electrodonkey/roza_reflow_hw/output/reflow_roza.png

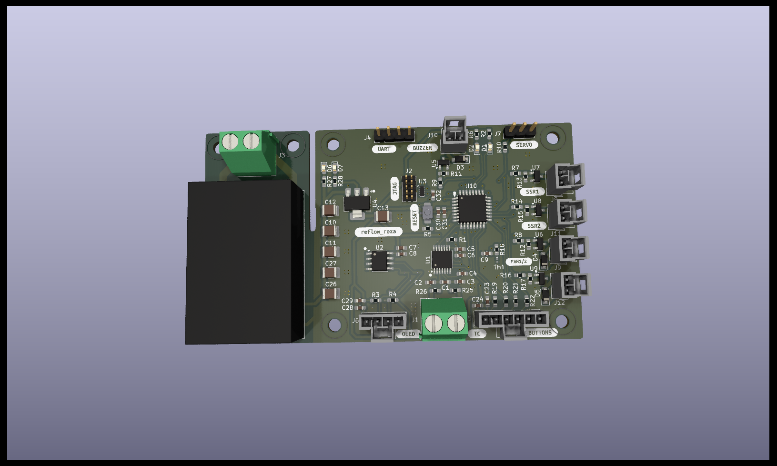
output/reflow_roza.png
