electrodonkey/roza_reflow_hw/3d/molex_nanofit_1053091108.stp

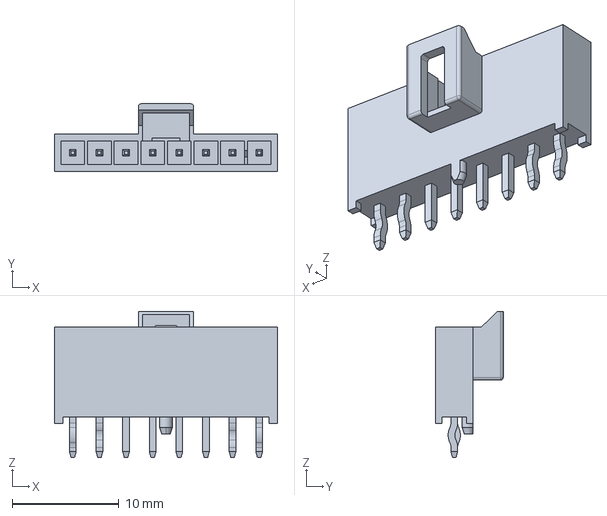
[picture p2: CAD file, 2024-12-30]
3d/molex_nanofit_1053091108.stp
20.9 x 6.34 x 13.7 mm
