electrodonkey/roza_reflow_hw/enclosure/reference/OLED+Display+Case.step

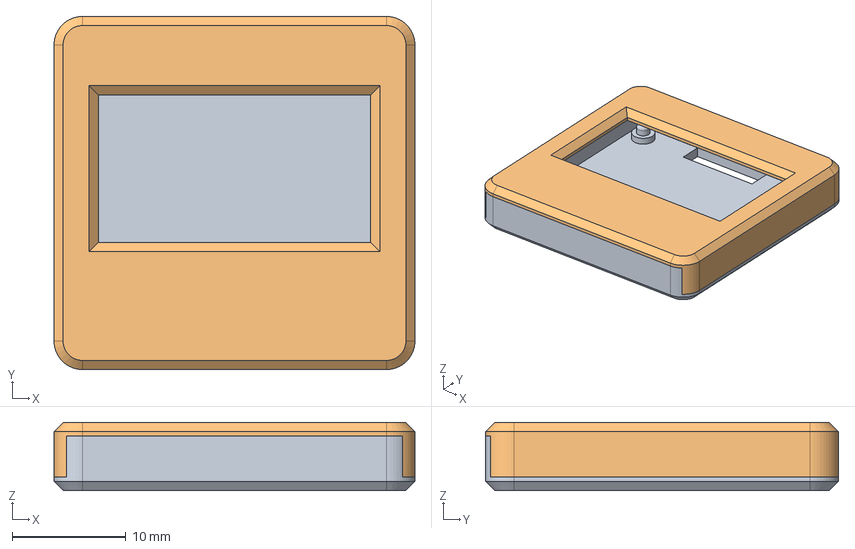
[picture p3: CAD file, 2025-01-08]
enclosure/reference/OLED+Display+Case.step
31.8 x 31.1 x 6.00 mm
Base
Lid
