electrodonkey/roza_reflow_hw/output/reflow_master.step

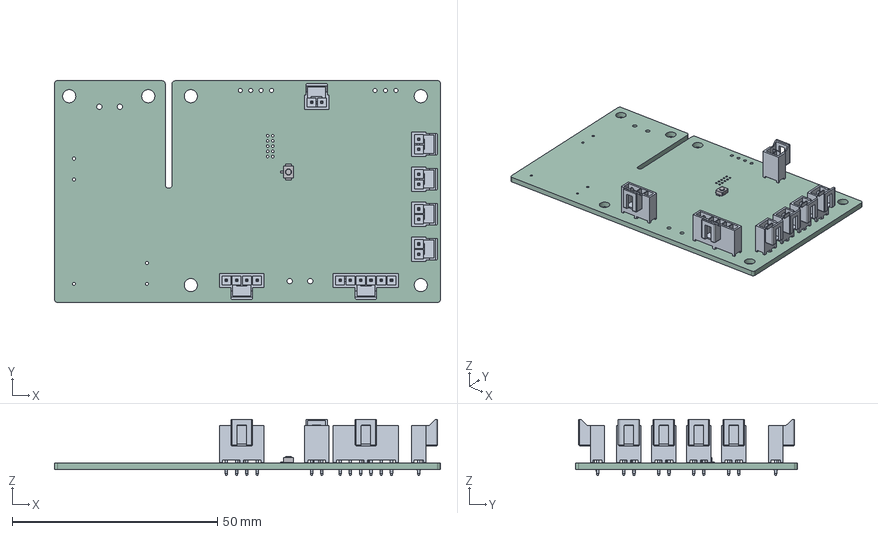
[picture p4: CAD file, 2024-12-30]
output/reflow_master.step
94.0 x 54.0 x 13.7 mm
root
reflow_master_PCB
