electrodonkey/roza_reflow_hw/3d/molex_nanofit_1053091104.stp

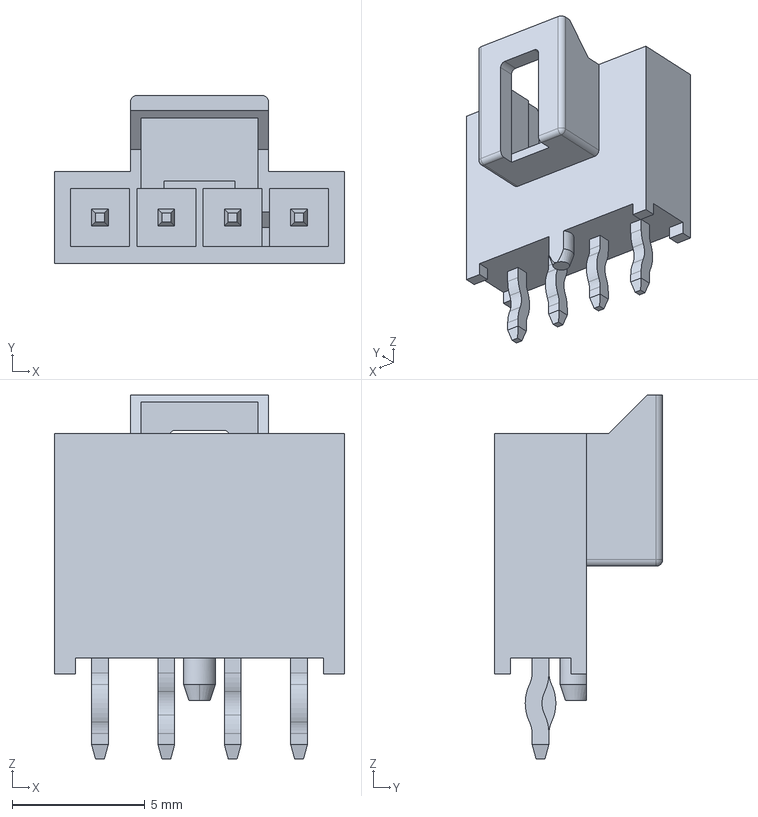
[picture p5: CAD file, 2024-12-30]
3d/molex_nanofit_1053091104.stp
10.9 x 6.34 x 13.7 mm
