electrodonkey/roza_reflow_hw/enclosure/reference/User Library-128x64I2COLEDDisplayAdafruit.step

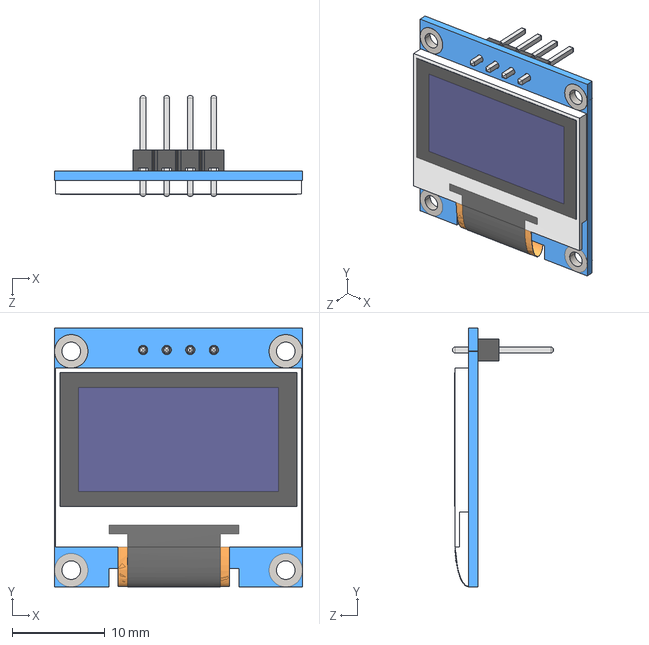
[picture p6: CAD file, 2025-01-08]
enclosure/reference/User Library-128x64I2COLEDDisplayAdafruit.step
26.7 x 27.9 x 10.8 mm
