electrodonkey/roza_reflow_hw/3d/TL1017AABF260QG.stp

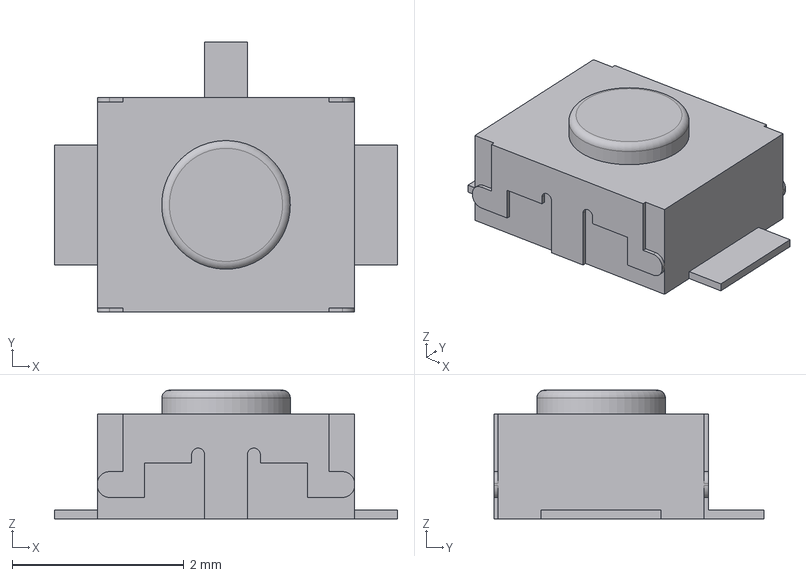
[picture p7: CAD file, 2024-12-30]
3d/TL1017AABF260QG.stp
4.00 x 3.15 x 1.50 mm
