electrodonkey/roza_reflow_hw/3d/molex_nanofit_1053091105.stp

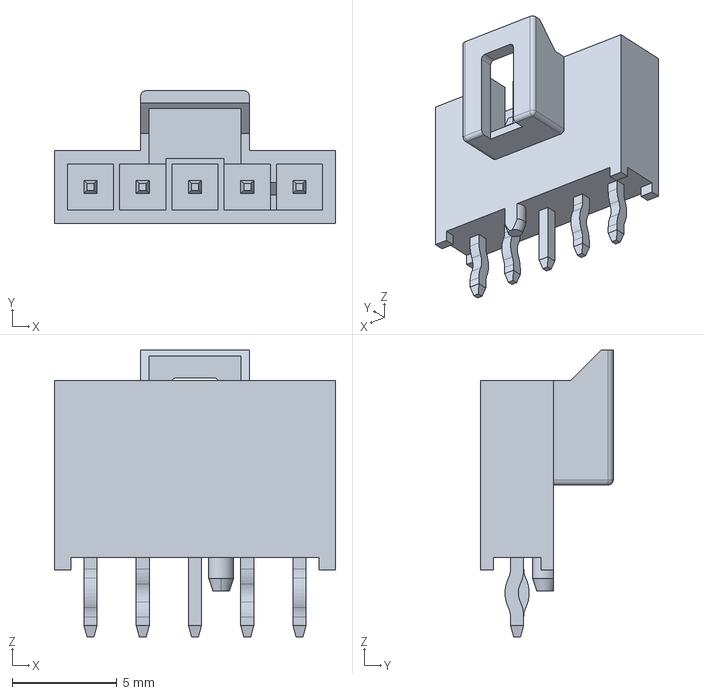
[picture p8: CAD file, 2024-12-30]
3d/molex_nanofit_1053091105.stp
13.4 x 6.34 x 13.7 mm
