electrodonkey/roza_reflow_hw/3d/molex_nanofit_1053091103.stp

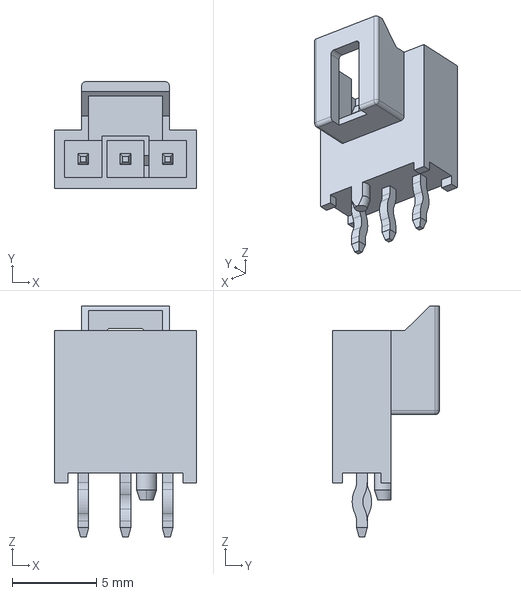
[picture p9: CAD file, 2024-12-30]
3d/molex_nanofit_1053091103.stp
8.44 x 6.34 x 13.7 mm
