electrodonkey/roza_reflow_hw/3d/molex_nanofit_1053091106.stp

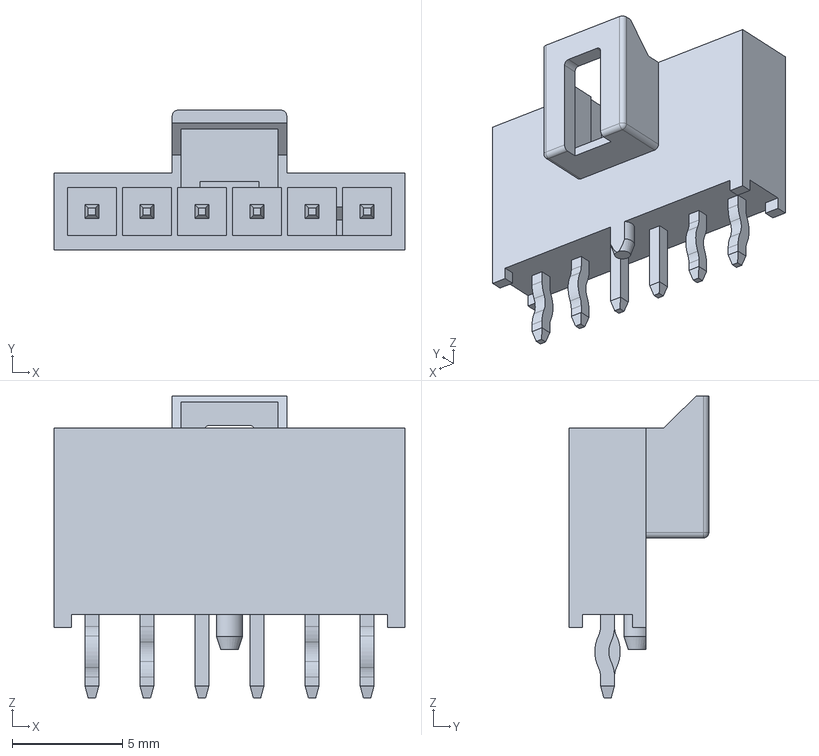
[picture p10: CAD file, 2024-12-30]
3d/molex_nanofit_1053091106.stp
15.9 x 6.34 x 13.7 mm
