electrodonkey/roza_reflow_hw/3d/molex_nanofit_x2_1053091102.stp

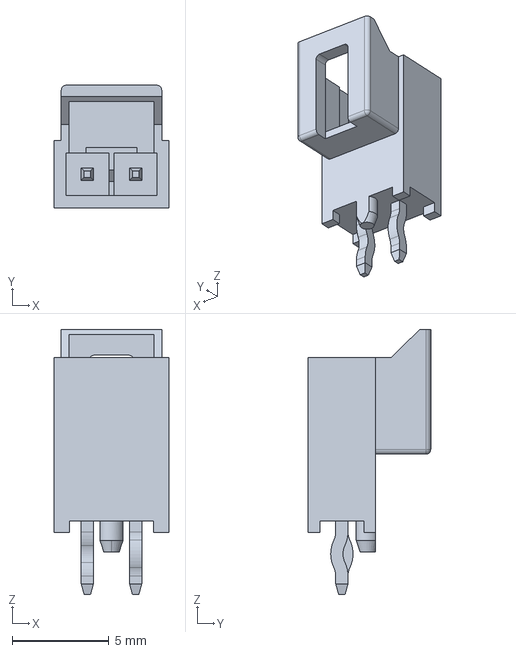
[picture p12: CAD file, 2024-12-30]
3d/molex_nanofit_x2_1053091102.stp
5.94 x 6.34 x 13.7 mm
