electrodonkey/roza_reflow_hw/(list of files, cad)

Other CAD files:
output/enclosure.FCStd
enclosure/reference/OLED+Display+Case.f3d
