electrodonkey/roza_reflow_hw/output/reflow_master.pdf

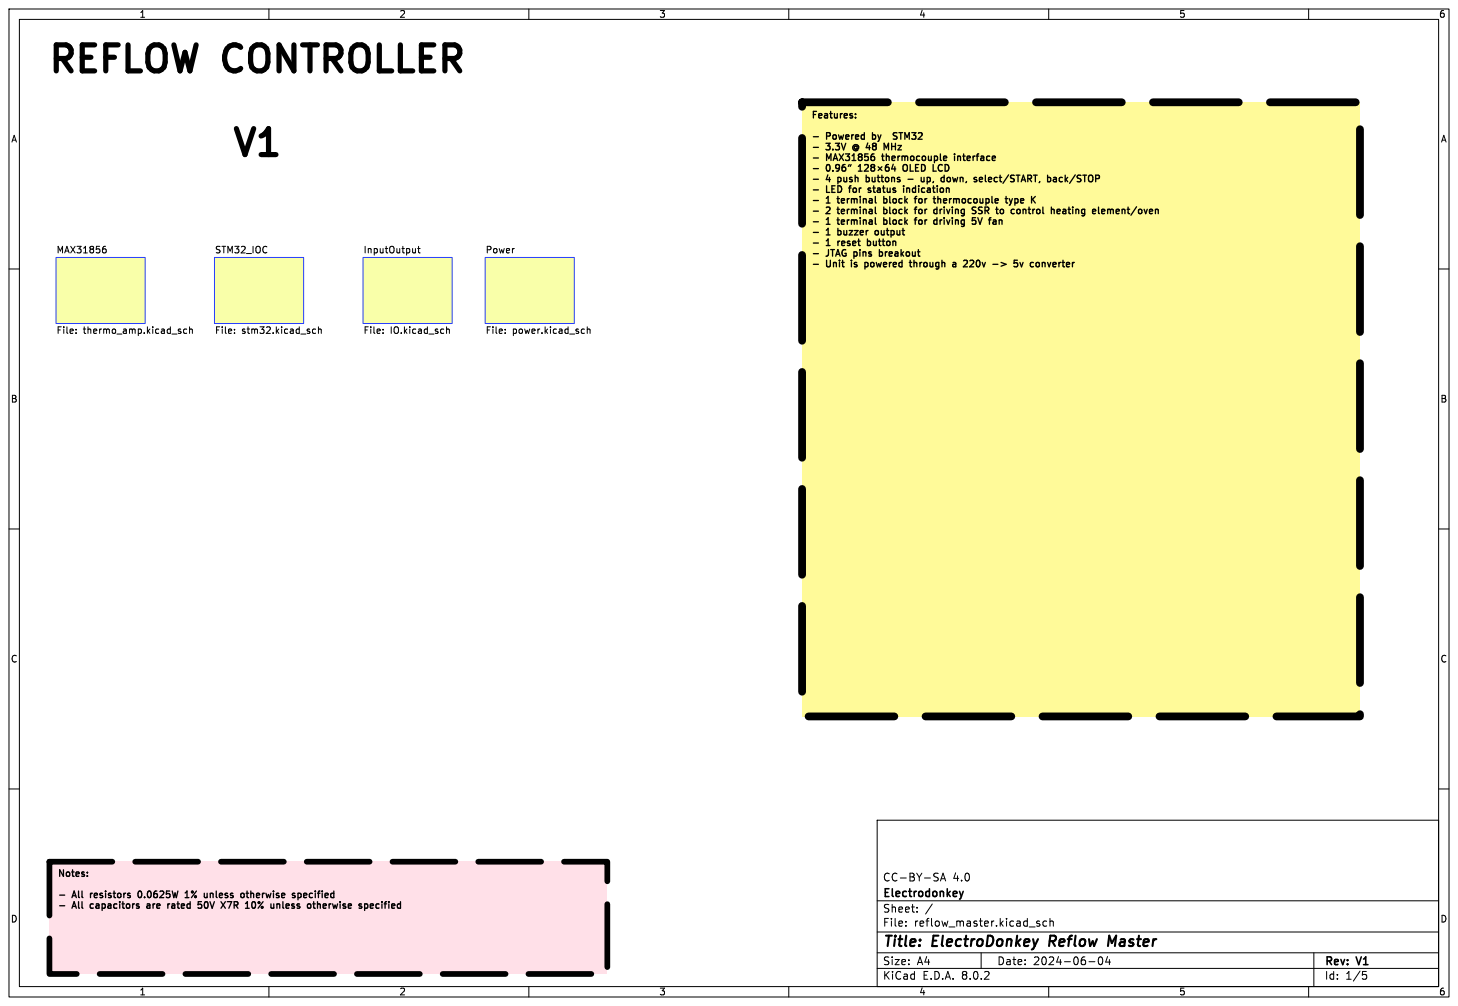
[picture p13: page 1]

- 3.3V @ 48 MHz
- þÿ0.96 3 þÿ128×64OLED LCD
- LED for status indication
- 2 terminal block for driving SSR to control heating element/oven
- 1 terminal block for driving 5V fan
- 1 buzzer output
- 1 reset button
- JTAG pins breakout

- All resistors 0.0625W 1% unless otherwise specified

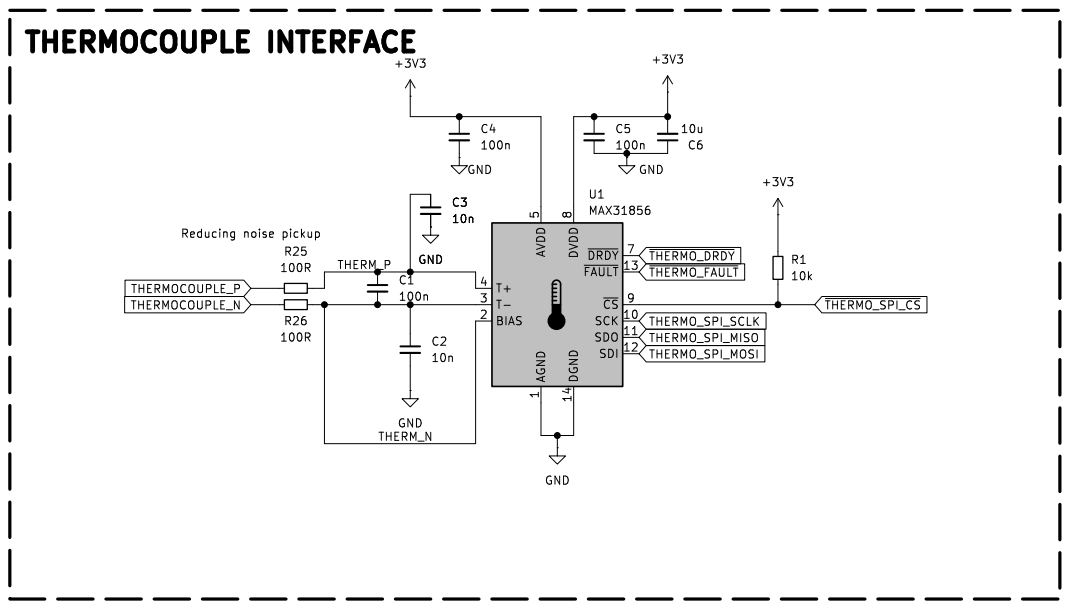
[picture p14: page 2]

1 SCK 10 SDO 11 SDI 12 ~{FAULT} 13 DGND 14 BIAS 2 T- 3 T+ 4 AVDD

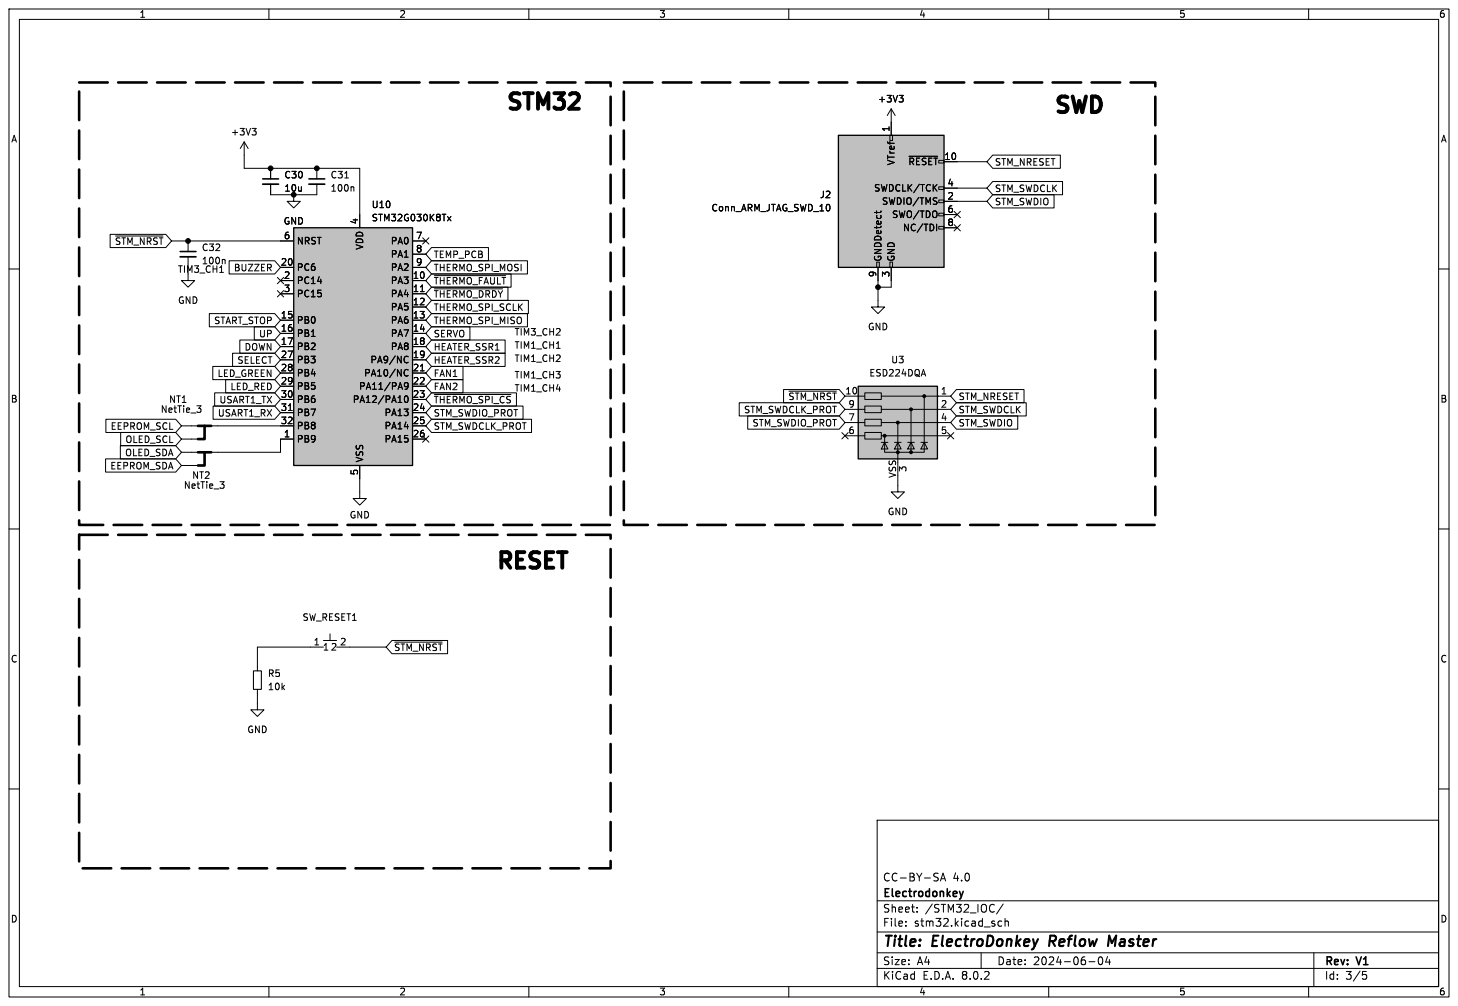
[picture p15: page 3]

3 SWDCLK/TCK 4 SWO/TDO 6 NC/TDI 8 GNDDetect 9 +3V3 GND

5 NRST 6 PA0 7 PA1 8 PA2 9 U10 STM32G030K8Tx +3V3VTref 1 ~{RESET}10 SWDIO/TMS 2 GND

3 SWDCLK/TCK 4 SWO/TDO 6 NC/TDI 8 GNDDetect 9

Id: 3/5 Title: ElectroDonkey Reflow Master File: stm32.kicad_sch Sheet: /STM32_IOC/

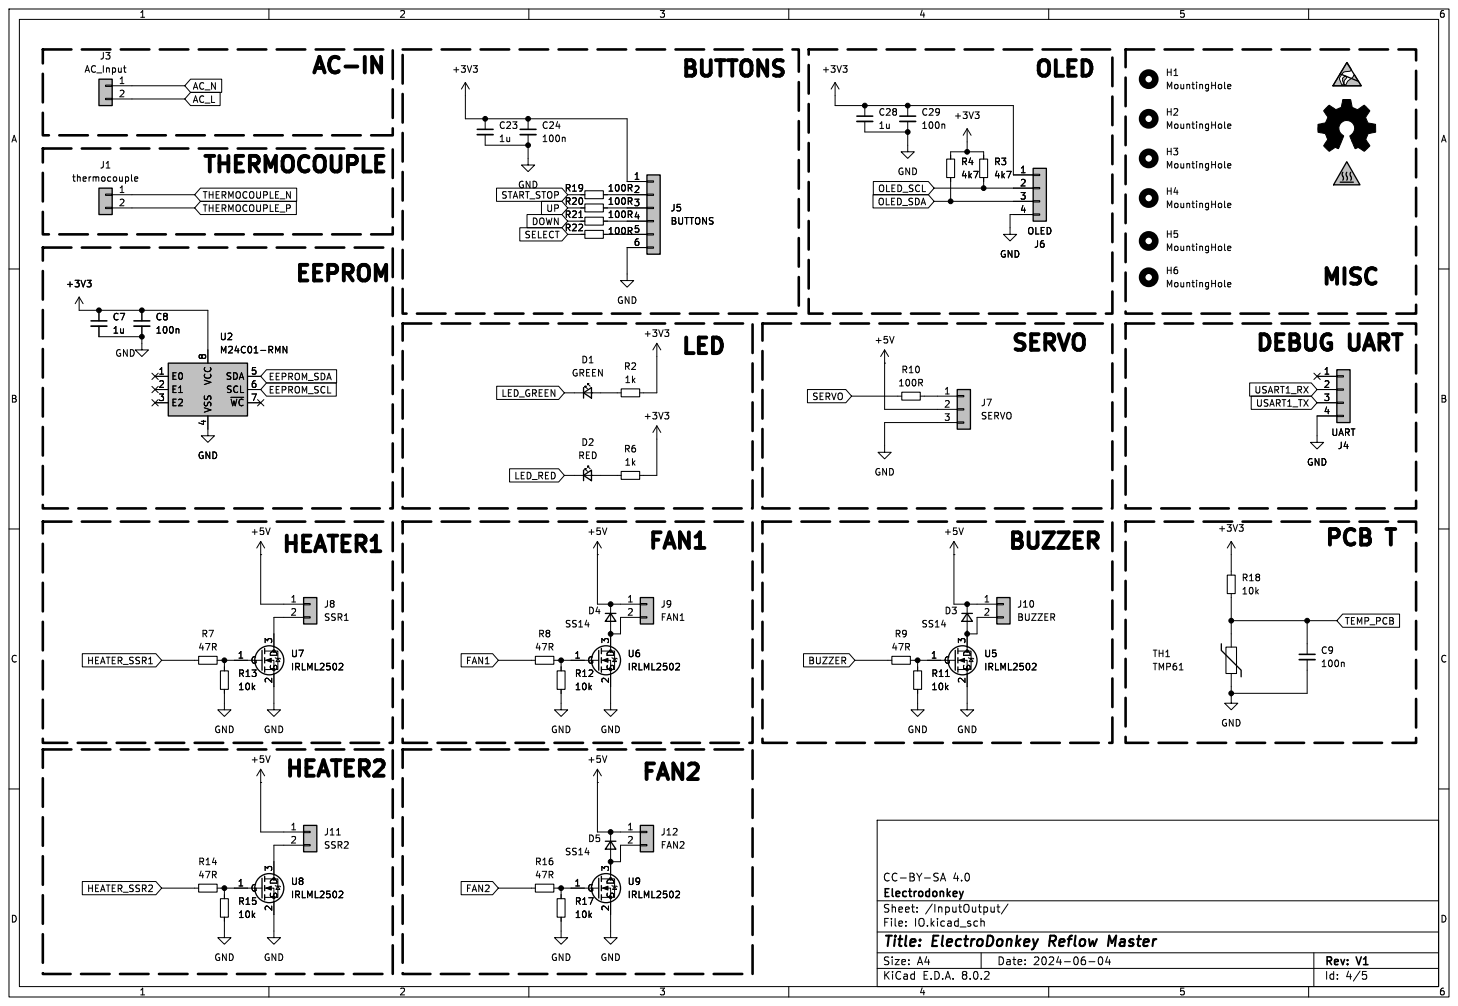
[picture p16: page 4]

4 SDA 5 SCL 6 ~{WC}7 VCC

Id: 4/5 Title: ElectroDonkey Reflow Master File: IO.kicad_sch Sheet: /InputOutput/

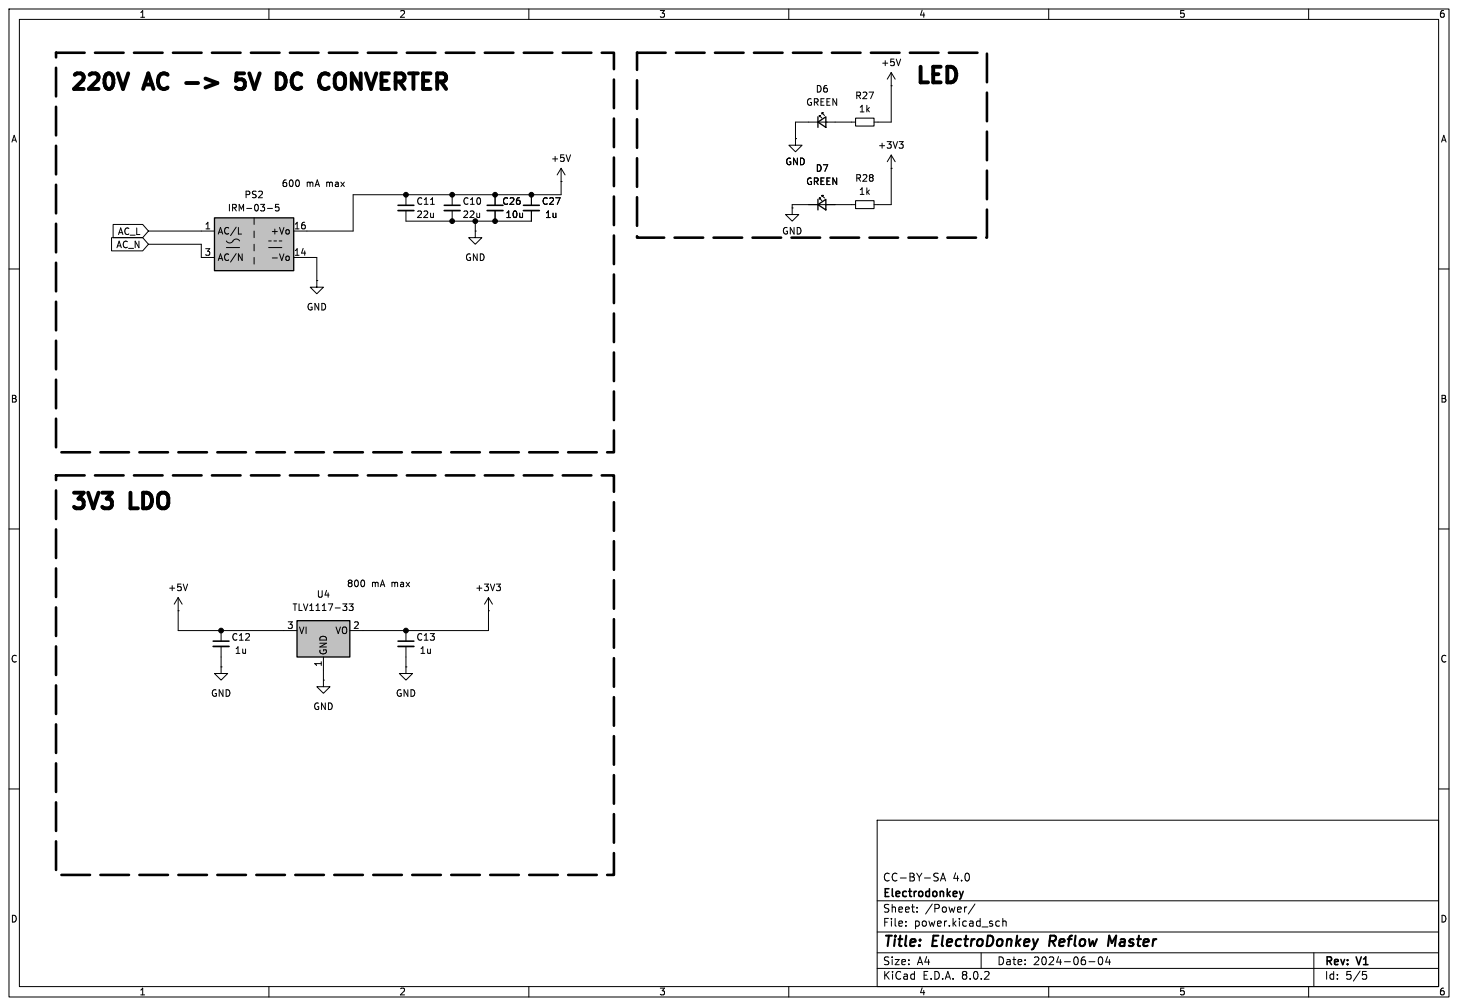
[picture p17: page 5]

1 VO 2 VI 3 U4 TLV1117-33 +3V3 GND GND
