electrodonkey/roza_reflow_hw/reflow_master.kicad_pcb

## KiCad design reflow_master.kicad_pcb (2024-12-30)

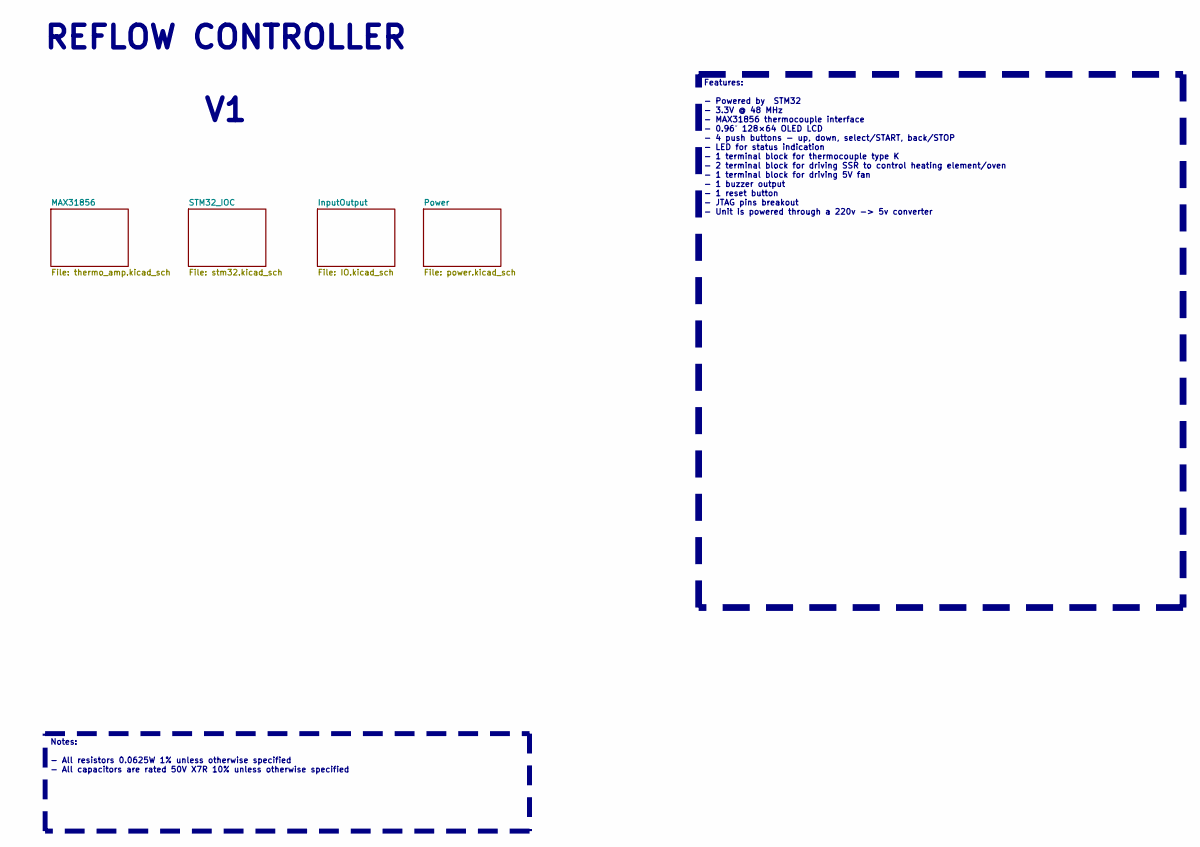
[picture p18: schematic reflow_master.kicad_sch, ElectroDonkey Reflow Master]

Notes on the sheet:
Features: - Powered by STM32 - 3.3V @ 48 MHz - MAX31856 thermocouple interface - 0.96″ 128×64 OLED LCD - 4 push buttons - up, down, select/START, back/STOP - LED for status indication - 1 terminal block for thermocouple type K - 2 terminal block for driving SSR to control heating element/oven - 1 t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
Notes: - All resistors 0.0625W 1% unless otherwise specified - All capacitors are rated 50V X7R 10% unless otherwise specified
REFLOW CONTROLLER ${REVISION}

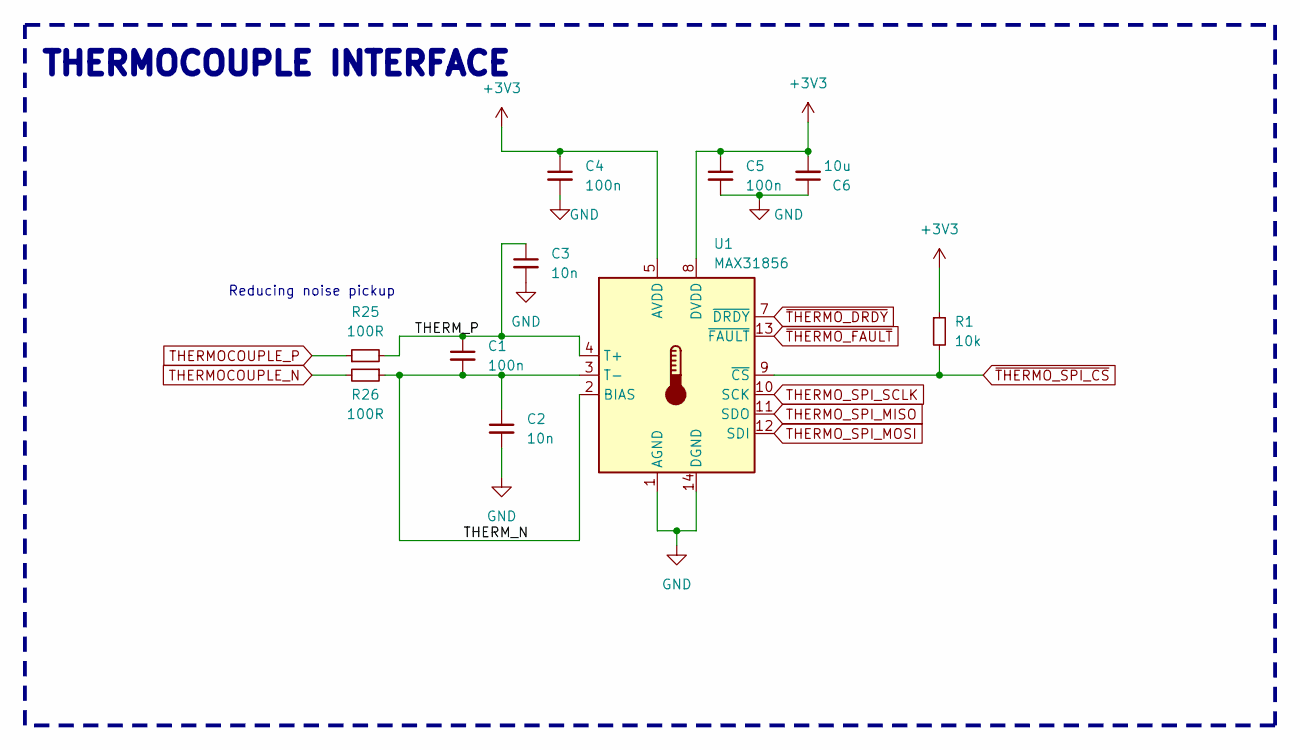
[picture p19: schematic thermo_amp.kicad_sch, ElectroDonkey Reflow Master]

Parts:
C1, C4, C5: 100n; C_0603_1608Metric_Pad1.08x0.95mm_HandSolder
C2, C3: 10n; C_0603_1608Metric_Pad1.08x0.95mm_HandSolder
C6: 10u; C_0603_1608Metric_Pad1.08x0.95mm_HandSolder
R1: 10k; R_0603_1608Metric_Pad0.98x0.95mm_HandSolder
R25, R26: 100R; R_0603_1608Metric_Pad0.98x0.95mm_HandSolder
U1: MAX31856; TSSOP-14_4.4x5mm_P0.65mm

Connections:
+3V3: C4.1, C5.1, C6.2, R1.1, U1.5 (AVDD), U1.8 (DVDD); also elsewhere on the board
/MAX31856/THERM_N: C1.2, C2.1, R26.1, U1.2 (BIAS), U1.3 (T-)
/MAX31856/THERM_P: C1.1, C3.1, R25.2, U1.4 (T+)
GND: C2.2, C3.2, C4.2, C5.2, C6.1, U1.1 (AGND), U1.14 (DGND); also elsewhere on the board
THERMOCOUPLE_N: R26.2; also elsewhere on the board
THERMOCOUPLE_P: R25.1; also elsewhere on the board
THERMO_SPI_MISO: U1.11 (SDO); also elsewhere on the board
THERMO_SPI_MOSI: U1.12 (SDI); also elsewhere on the board
THERMO_SPI_SCLK: U1.10 (SCK); also elsewhere on the board
~THERMO_DRDY: U1.7 (~DRDY); also elsewhere on the board
~THERMO_FAULT: U1.13 (~FAULT); also elsewhere on the board
~THERMO_SPI_CS: R1.2, U1.9 (~CS); also elsewhere on the board

Notes on the sheet:
Reducing noise pickup
THERMOCOUPLE INTERFACE

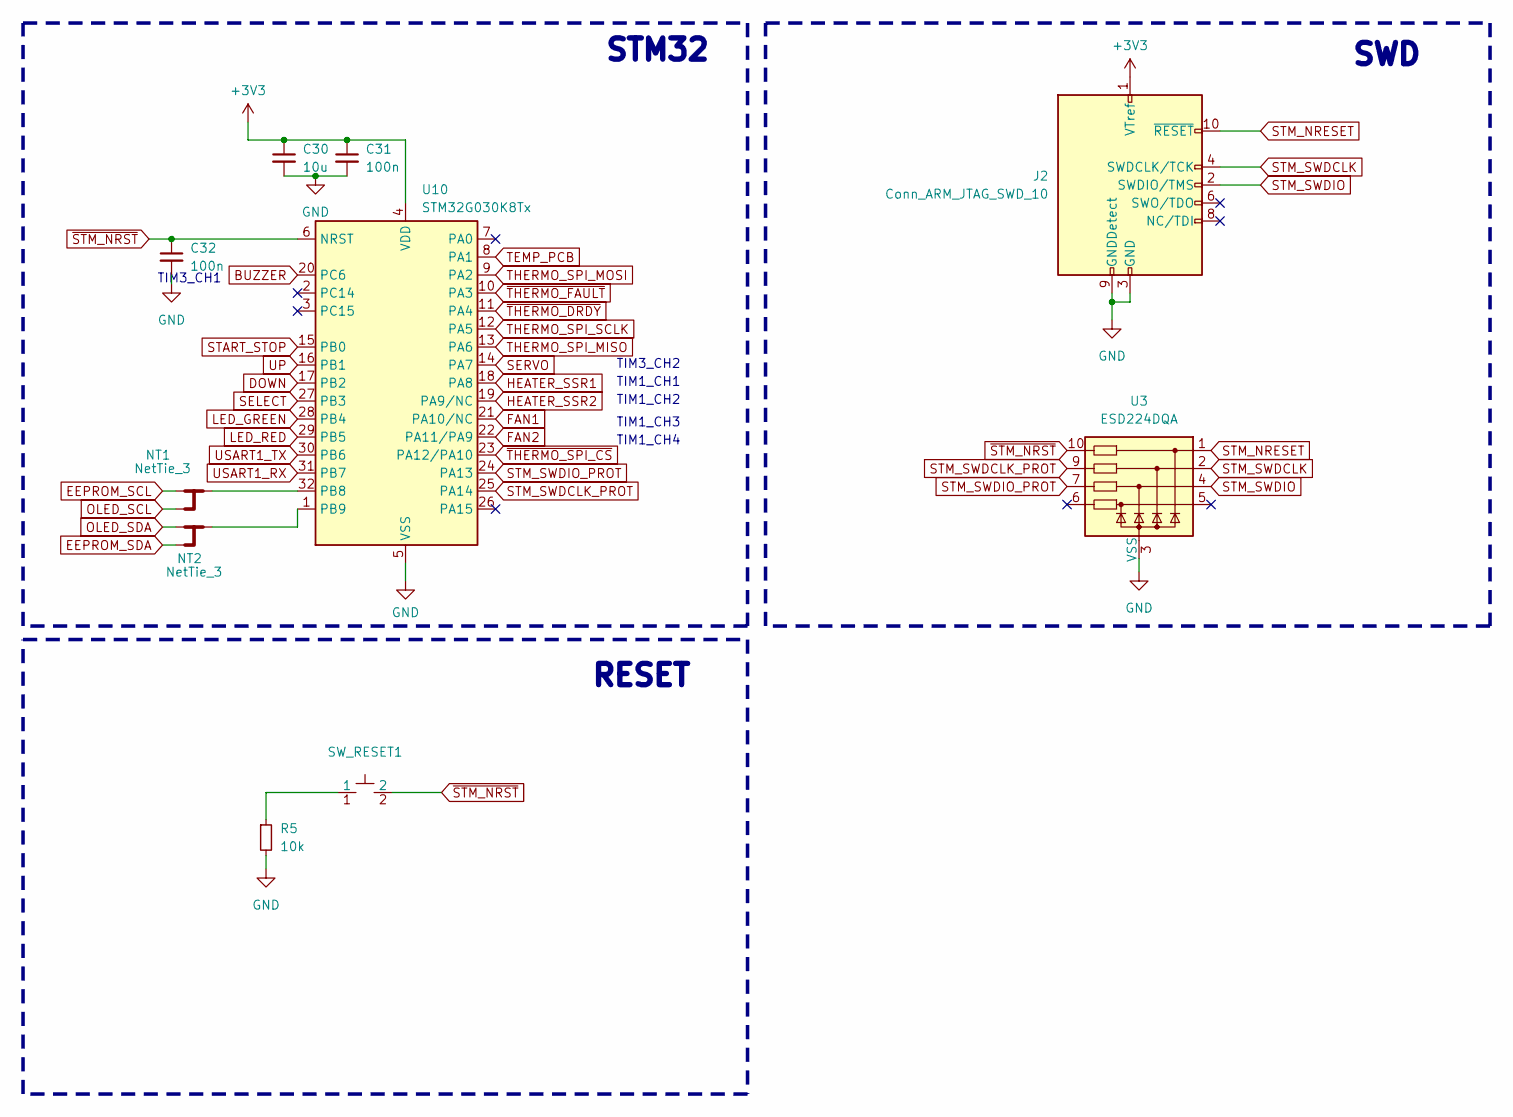
[picture p20: schematic stm32.kicad_sch, ElectroDonkey Reflow Master]

Parts:
C30: 10u; C_0603_1608Metric_Pad1.08x0.95mm_HandSolder
C31, C32: 100n; C_0603_1608Metric_Pad1.08x0.95mm_HandSolder
J2: Conn_ARM_JTAG_SWD_10; PinHeader_2x05_P1.27mm_Vertical
NT1, NT2: NetTie_3; NetTie-3_SMD_Pad0.5mm
R5: 10k; R_0603_1608Metric_Pad0.98x0.95mm_HandSolder
SW_RESET1: TL1017AABF160QG
U3: ESD224DQA; Diodes_UDFN-10_1.0x2.5mm_P0.5mm
U10: STM32G030K8Tx; LQFP-32_7x7mm_P0.8mm

Connections:
+3V3: C30.1, C31.1, J2.1 (VTref), U10.4 (VDD); also elsewhere on the board
BUZZER: U10.20 (PC6); also elsewhere on the board
DOWN: U10.17 (PB2); also elsewhere on the board
EEPROM_SCL: NT1.1; also elsewhere on the board
EEPROM_SDA: NT2.3; also elsewhere on the board
FAN1: U10.21 (PA10/NC); also elsewhere on the board
FAN2: U10.22 (PA11/PA9); also elsewhere on the board
GND: C30.2, C31.2, C32.2, J2.3 (GND), J2.5 (GND), J2.9 (GNDDetect), R5.2, U3.3 (VSS), U3.8 (VSS), U10.5 (VSS); also elsewhere on the board
HEATER_SSR1: U10.18 (PA8); also elsewhere on the board
HEATER_SSR2: U10.19 (PA9/NC); also elsewhere on the board
LED_GREEN: U10.28 (PB4); also elsewhere on the board
LED_RED: U10.29 (PB5); also elsewhere on the board
unnamed: R5.1, SW_RESET1.1
unnamed: NT1.2, U10.32 (PB8)
unnamed: NT2.2, U10.1 (PB9)
OLED_SCL: NT1.3; also elsewhere on the board
OLED_SDA: NT2.1; also elsewhere on the board
SELECT: U10.27 (PB3); also elsewhere on the board
SERVO: U10.14 (PA7); also elsewhere on the board
START_STOP: U10.15 (PB0); also elsewhere on the board
STM_NRESET: J2.10 (~RESET), U3.1
STM_SWDCLK: J2.4 (SWDCLK/TCK), U3.2
STM_SWDCLK_PROT: U3.9, U10.25 (PA14)
STM_SWDIO: J2.2 (SWDIO/TMS), U3.4
STM_SWDIO_PROT: U3.7, U10.24 (PA13)
TEMP_PCB: U10.8 (PA1); also elsewhere on the board
THERMO_SPI_MISO: U10.13 (PA6); also elsewhere on the board
THERMO_SPI_MOSI: U10.9 (PA2); also elsewhere on the board
THERMO_SPI_SCLK: U10.12 (PA5); also elsewhere on the board
UP: U10.16 (PB1); also elsewhere on the board
USART1_RX: U10.31 (PB7); also elsewhere on the board
USART1_TX: U10.30 (PB6); also elsewhere on the board
~STM_NRST: C32.1, SW_RESET1.2, U3.10, U10.6 (NRST)
~THERMO_DRDY: U10.11 (PA4); also elsewhere on the board
~THERMO_FAULT: U10.10 (PA3); also elsewhere on the board
~THERMO_SPI_CS: U10.23 (PA12/PA10); also elsewhere on the board

Notes on the sheet:
TIM1_CH2
TIM3_CH1
STM32
RESET
TIM1_CH3
TIM3_CH2
SWD
TIM1_CH4
TIM1_CH1

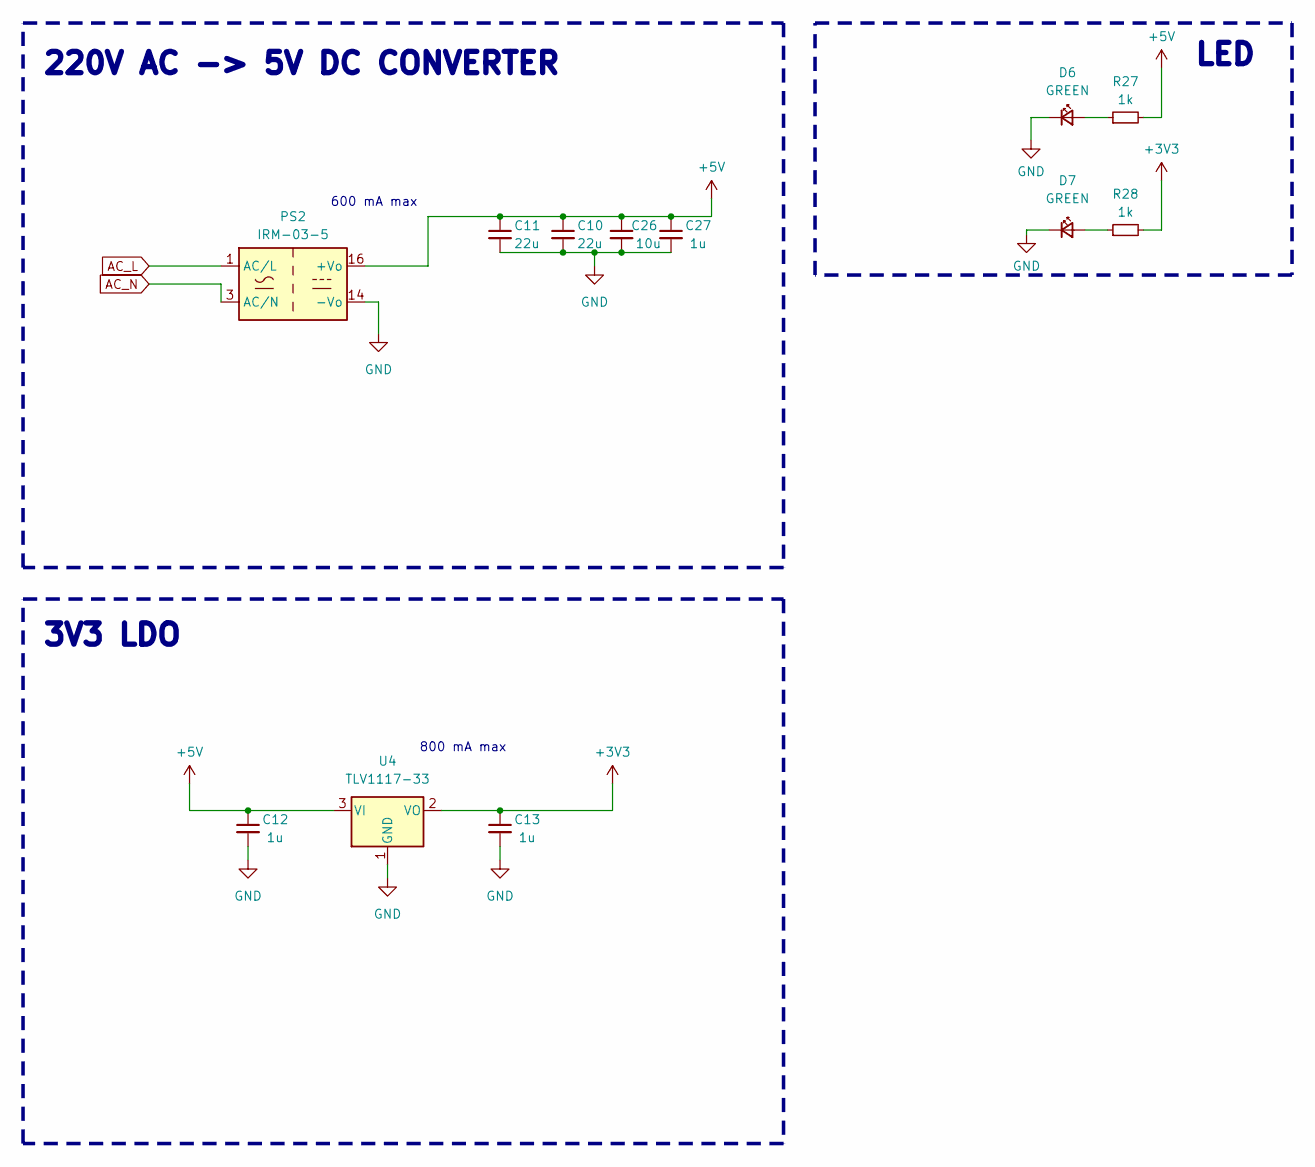
[picture p21: schematic power.kicad_sch, ElectroDonkey Reflow Master]

Parts:
C10, C11: 22u; C_1210_3225Metric_Pad1.33x2.70mm_HandSolder
C12, C13, C27: 1u; C_1210_3225Metric_Pad1.33x2.70mm_HandSolder
C26: 10u; C_1210_3225Metric_Pad1.33x2.70mm_HandSolder
D6, D7: GREEN; LED_0603_1608Metric_Pad1.05x0.95mm_HandSolder
PS2: IRM-03-5; Converter_ACDC_MeanWell_IRM-03-xx_THT
R27, R28: 1k; R_0603_1608Metric_Pad0.98x0.95mm_HandSolder
U4: TLV1117-33; SOT-223-3_TabPin2

Connections:
+3V3: C13.1, R28.2, U4.2 (VO); also elsewhere on the board
+5V: C10.1, C11.1, C12.1, C26.1, C27.1, PS2.16 (+Vo), R27.2, U4.3 (VI); also elsewhere on the board
AC_L: PS2.1 (AC/L); also elsewhere on the board
AC_N: PS2.3 (AC/N); also elsewhere on the board
GND: C10.2, C11.2, C12.2, C13.2, C26.2, C27.2, D6.1 (K), D7.1 (K), PS2.14 (-Vo), U4.1 (GND); also elsewhere on the board
unnamed: D6.2 (A), R27.1
unnamed: D7.2 (A), R28.1

Notes on the sheet:
3V3 LDO
220V AC -> 5V DC CONVERTER
LED
600 mA max
800 mA max

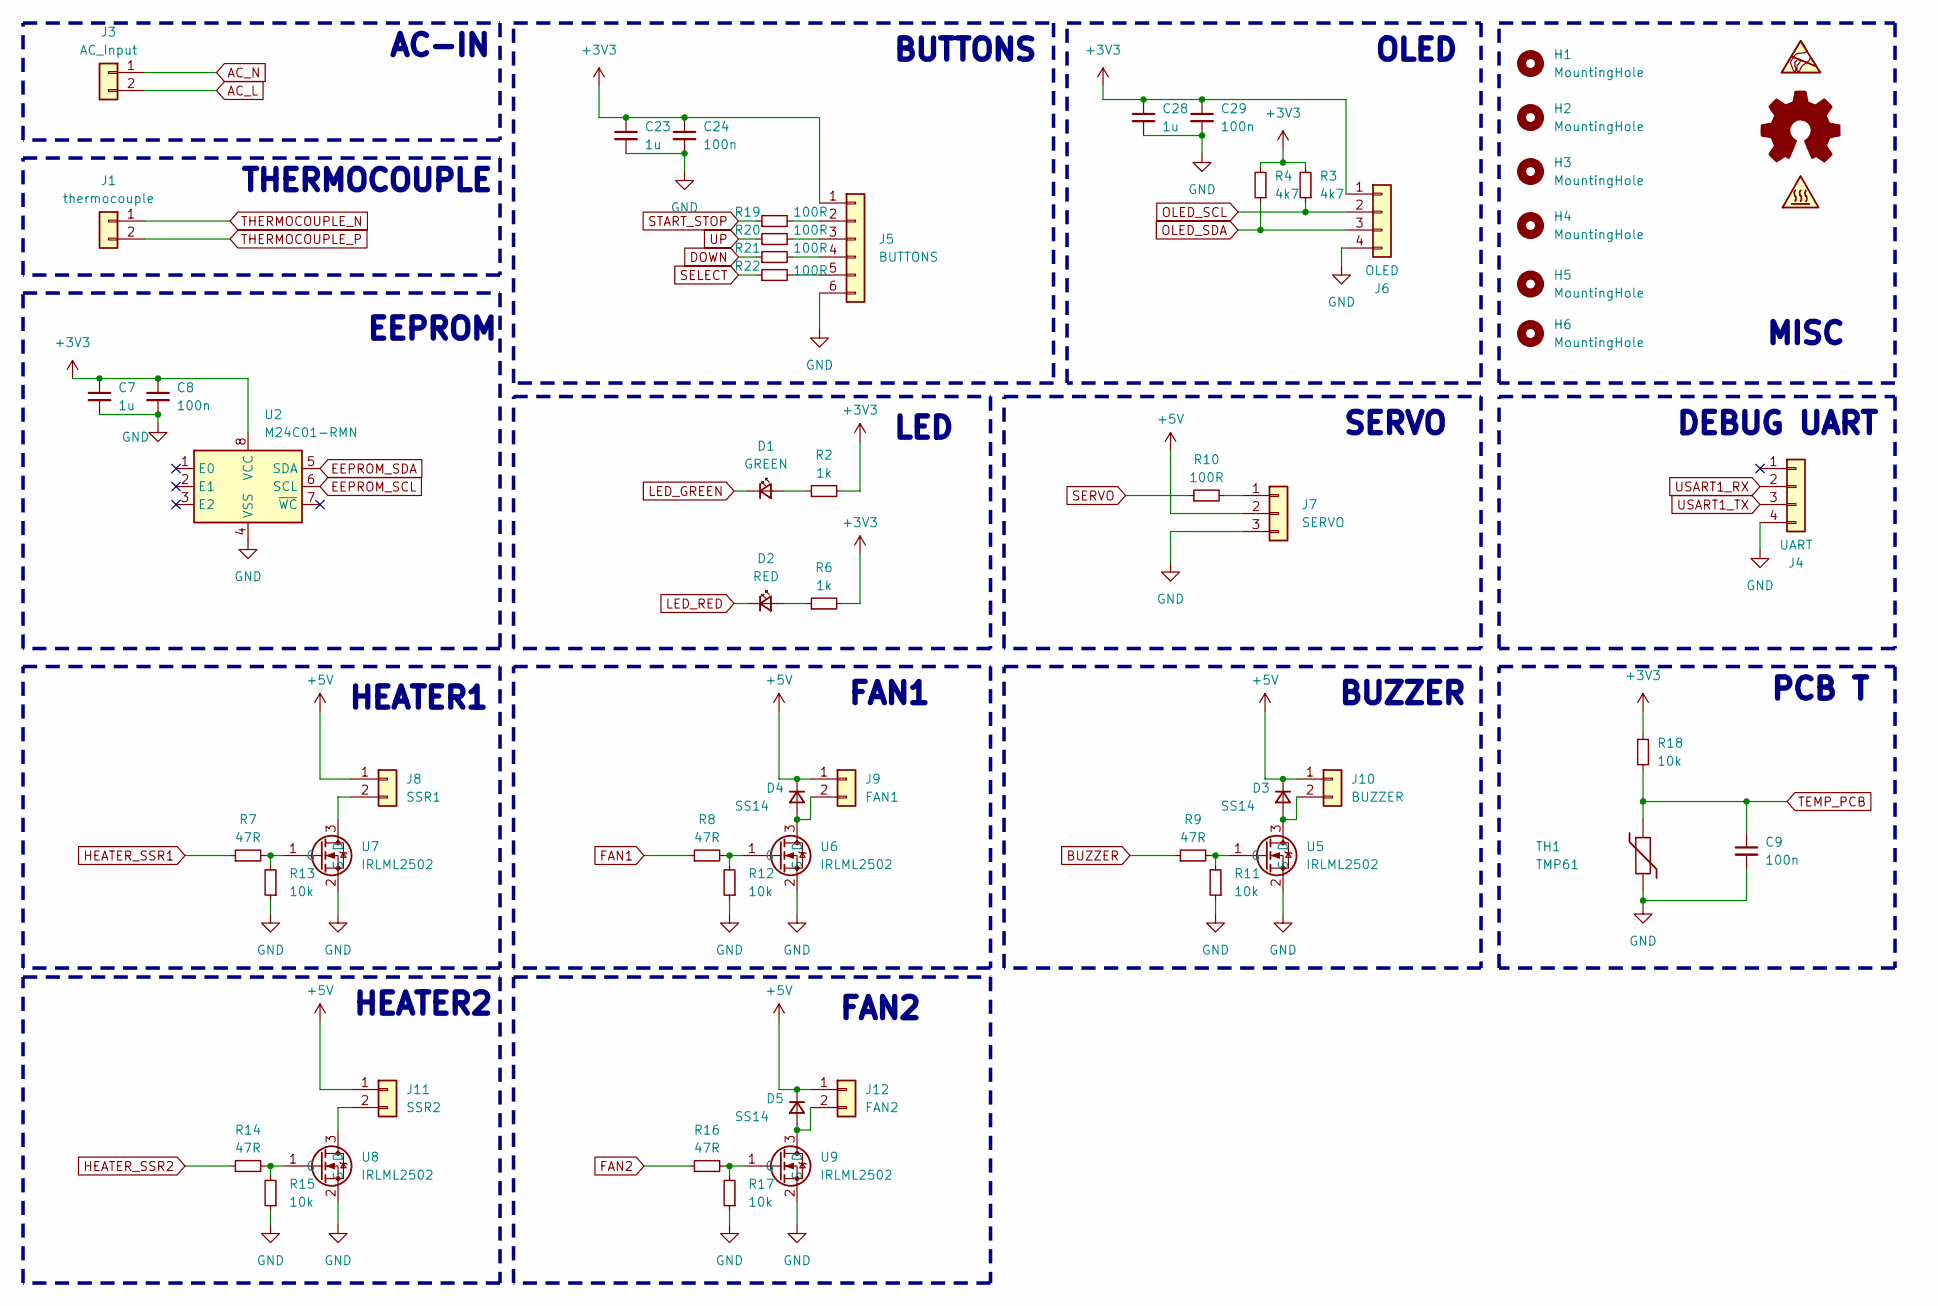
[picture p22: schematic IO.kicad_sch, ElectroDonkey Reflow Master]

Parts:
C7, C23, C28: 1u; C_0603_1608Metric_Pad1.08x0.95mm_HandSolder
C8, C9, C24, C29: 100n; C_0603_1608Metric_Pad1.08x0.95mm_HandSolder
D1: GREEN; LED_0603_1608Metric_Pad1.05x0.95mm_HandSolder
D2: RED; LED_0603_1608Metric_Pad1.05x0.95mm_HandSolder
D3, D4, D5: SS14; D_SOD-123
H1, H2, H3, H4, H5, H6: MountingHole; MountingHole_3.2mm_M3
J1: thermocouple; TerminalBlock_Phoenix_MKDS-1,5-2_1x02_P5.00mm_Horizontal
J3: AC_Input; TerminalBlock_Phoenix_MKDS-1,5-2_1x02_P5.00mm_Horizontal
J4: UART; PinHeader_1x04_P2.54mm_Vertical
J5: BUTTONS; Molex_Nano-Fit_105309-xx06_1x06_P2.50mm_Vertical
J6: OLED; Molex_Nano-Fit_105309-xx04_1x04_P2.50mm_Vertical
J7: SERVO; PinHeader_1x03_P2.54mm_Vertical
J8: SSR1; Molex_Nano-Fit_105309-xx02_1x02_P2.50mm_Vertical
J9: FAN1; Molex_Nano-Fit_105309-xx02_1x02_P2.50mm_Vertical
J10: BUZZER; Molex_Nano-Fit_105309-xx02_1x02_P2.50mm_Vertical
J11: SSR2; Molex_Nano-Fit_105309-xx02_1x02_P2.50mm_Vertical
J12: FAN2; Molex_Nano-Fit_105309-xx02_1x02_P2.50mm_Vertical
R2, R6: 1k; R_0603_1608Metric_Pad0.98x0.95mm_HandSolder
R3, R4: 4k7; R_0603_1608Metric_Pad0.98x0.95mm_HandSolder
R7, R8, R9, R14, R16: 47R; R_0603_1608Metric_Pad0.98x0.95mm_HandSolder
R10, R19, R20, R21, R22: 100R; R_0603_1608Metric_Pad0.98x0.95mm_HandSolder
R11, R12, R13, R15, R17, R18: 10k; R_0603_1608Metric_Pad0.98x0.95mm_HandSolder
TH1: TMP61; Texas_DPY0002A_0.6x1mm_P0.65mm
U2: M24C01-RMN; SOIC-8_3.9x4.9mm_P1.27mm
U5, U6, U7, U8, U9: IRLML2502; SOT-23

Connections:
+3V3: C7.1, C8.1, C23.1, C24.1, C28.1, C29.1, J5.1, J6.1, R2.2, R3.2, R4.2, R6.2, R18.1, U2.8 (VCC); also elsewhere on the board
+5V: D3.1 (K), D4.1 (K), D5.1 (K), J7.2, J8.1, J9.1, J10.1, J11.1, J12.1; also elsewhere on the board
AC_L: J3.2; also elsewhere on the board
AC_N: J3.1; also elsewhere on the board
BUZZER: R9.1; also elsewhere on the board
DOWN: R21.1; also elsewhere on the board
EEPROM_SCL: U2.6 (SCL); also elsewhere on the board
EEPROM_SDA: U2.5 (SDA); also elsewhere on the board
FAN1: R8.1; also elsewhere on the board
FAN2: R16.1; also elsewhere on the board
GND: C7.2, C8.2, C9.2, C23.2, C24.2, C28.2, C29.2, J4.4, J5.6, J6.4, J7.3, R11.1, R12.1, R13.1, R15.1, R17.1, TH1.2, U2.4 (VSS), U5.2 (S), U6.2 (S), U7.2 (S), U8.2 (S), U9.2 (S); also elsewhere on the board
HEATER_SSR1: R7.1; also elsewhere on the board
HEATER_SSR2: R14.1; also elsewhere on the board
LED_GREEN: D1.1 (K); also elsewhere on the board
LED_RED: D2.1 (K); also elsewhere on the board
unnamed: D1.2 (A), R2.1
unnamed: D2.2 (A), R6.1
unnamed: D3.2 (A), J10.2, U5.3 (D)
unnamed: D4.2 (A), J9.2, U6.3 (D)
unnamed: D5.2 (A), J12.2, U9.3 (D)
unnamed: J5.2, R19.2
unnamed: J5.3, R20.2
unnamed: J5.4, R21.2
unnamed: J5.5, R22.2
unnamed: J7.1, R10.2
unnamed: J8.2, U7.3 (D)
unnamed: J11.2, U8.3 (D)
unnamed: R9.2, R11.2, U5.1 (G)
unnamed: R8.2, R12.2, U6.1 (G)
unnamed: R7.2, R13.2, U7.1 (G)
unnamed: R14.2, R15.2, U8.1 (G)
unnamed: R16.2, R17.2, U9.1 (G)
OLED_SCL: J6.2, R3.1; also elsewhere on the board
OLED_SDA: J6.3, R4.1; also elsewhere on the board
SELECT: R22.1; also elsewhere on the board
SERVO: R10.1; also elsewhere on the board
START_STOP: R19.1; also elsewhere on the board
TEMP_PCB: C9.1, R18.2, TH1.1; also elsewhere on the board
THERMOCOUPLE_N: J1.1; also elsewhere on the board
THERMOCOUPLE_P: J1.2; also elsewhere on the board
UP: R20.1; also elsewhere on the board
USART1_RX: J4.2; also elsewhere on the board
USART1_TX: J4.3; also elsewhere on the board

Notes on the sheet:
HEATER2
OLED
BUTTONS
FAN2
AC-IN
EEPROM
BUZZER
THERMOCOUPLE
MISC
LED
HEATER1
PCB T
SERVO
FAN1
DEBUG UART

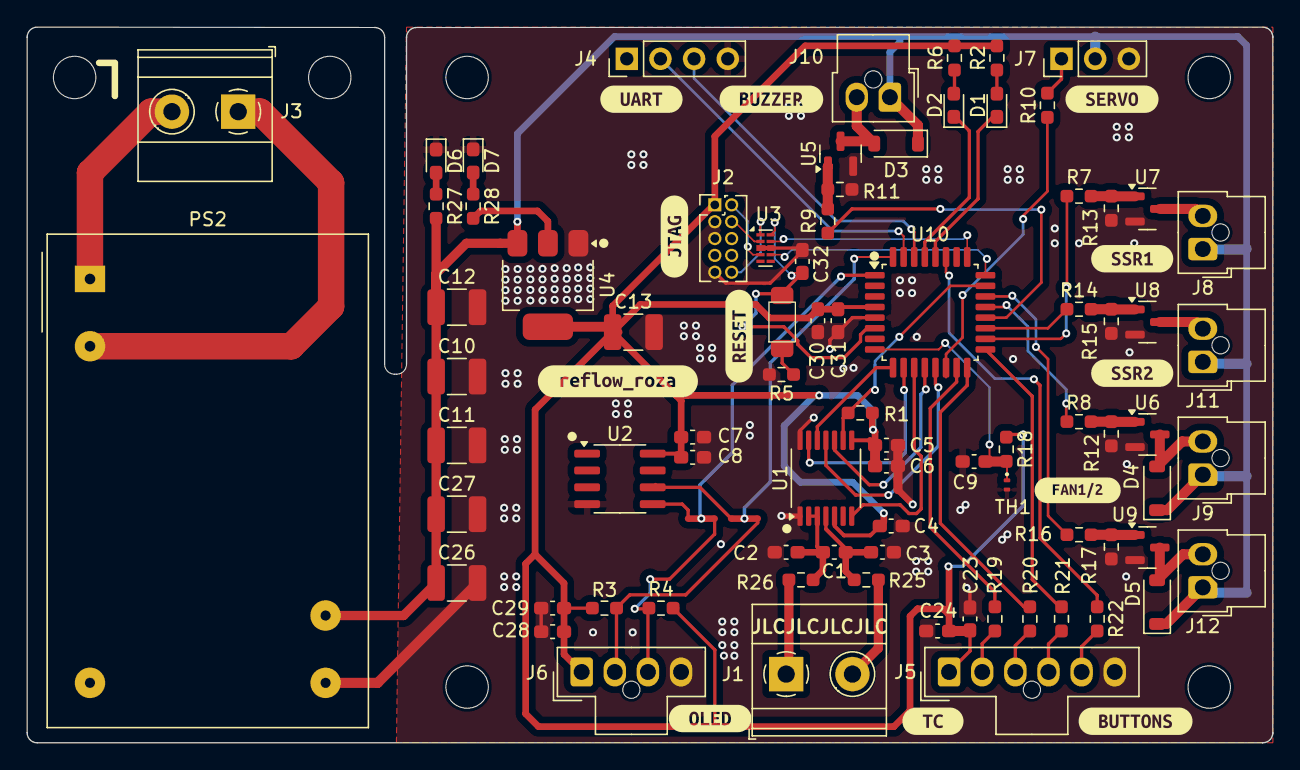
[picture p23: board reflow_master.kicad_pcb from above]

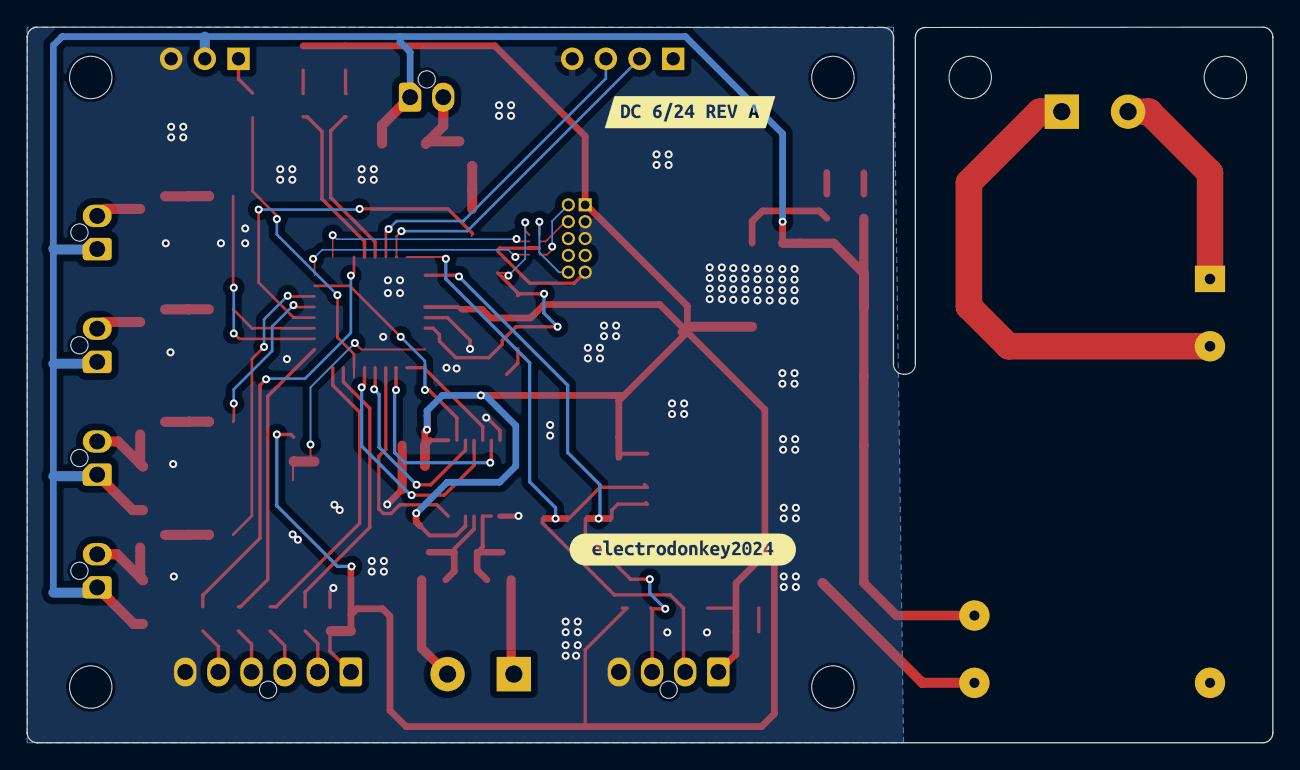
[picture p24: board reflow_master.kicad_pcb from below]

Board: 2 copper layers, 94.0 x 54.0 mm, 102 parts (2 on the bottom side), 62 nets.

Other parts of the board:
kibuzzard-667C6A5B: G***; kibuzzard-667C6A5B
kibuzzard-667C6A86: G***; kibuzzard-667C6A86
kibuzzard-667C6AA2: G***; kibuzzard-667C6AA2
kibuzzard-667C6CD5: G***; kibuzzard-667C6CD5
kibuzzard-667C6CE8: G***; kibuzzard-667C6CE8
kibuzzard-667C6E0B: G***; kibuzzard-667C6E0B
kibuzzard-667C6E5A: G***; kibuzzard-667C6E5A
kibuzzard-667C69AB: G***; kibuzzard-667C69AB
kibuzzard-667C69F0: G***; kibuzzard-667C69F0
kibuzzard-667C69F9: G***; kibuzzard-667C69F9
kibuzzard-667C6983: G***; kibuzzard-667C6983
kibuzzard-667C6993: G***; kibuzzard-667C6993
kibuzzard-667E6FEF: G***; kibuzzard-667E6FEF
kibuzzard-667F04CE: G***; kibuzzard-667F04CE
