electrodonkey/roza_reflow_hw/(commit log)

2024-12-30 Add initial produced files as of 30/12/2024
    [IO.kicad_sch, TL1017AABF260QG.stp, enclosure.FCStd, molex_nanofit_1053091102.stp, molex_nanofit_1053091103.stp, molex_nanofit_1053091104.stp, molex_nanofit_1053091105.stp, molex_nanofit_1053091106.stp]
2025-01-08 Add reference for enclosure design
    [OLED+Display+Case.f3d, OLED+Display+Case.step, User Library-128x64I2COLEDDisplayAdafruit.step]
