electrodonkey/roza_reflow_hw/(notices)

Notices in the files:
IO.kicad_sch:
CC-BY-SA 4.0
